Shihara1020/GP118-Line-Following-Robot/README.md

# Line Following Robot





An autonomous line-following robot powered by Arduino Uno, developed for the GP118 Line Following Competition, which secured 1st place against 60+ teams.

## Table of Contents
- [Competition Performance](#competition-performance)
- [Features](#features)
- [Project Task](#project-task)
- [Hardware Specifications](#hardware-specifications)
- [Media](#media)
- [Team](#team)
- [License](#license)

## Competition Performance
### Rounds Participated
| Round | Completion Time | Achievement |
|---|---|---|
| Preliminary | 16 seconds | Qualified for finals |
| Final | 21.9 seconds | **1st Place** |

### Key Achievement
- Beat the record time set by the 17th batch's robot
- Secured top position among 60+ competing teams

## Features
- Precise line following algorithm
- Automatic calibration system
- Robust performance across varying conditions
- Optimized speed control

## Project Task
The robot was designed to:
- Autonomously navigate complex line paths
- Handle sharp turns and intersections
- Maintain consistent speed and stability
- Adapt to different lighting and surface conditions

## Hardware Specifications
| Component | Description |
|---|---|
| Controller | Arduino Uno board |
| Motor Control | Motor shield |
| Sensors | IR sensor array |
| Actuators | 300 rpm gear motors |
| Power Management | Buck Converter, Boost Converter |
| Power Source | Battery pack |
| Mobility | Custom wheels |

## Media
### Robot Preview
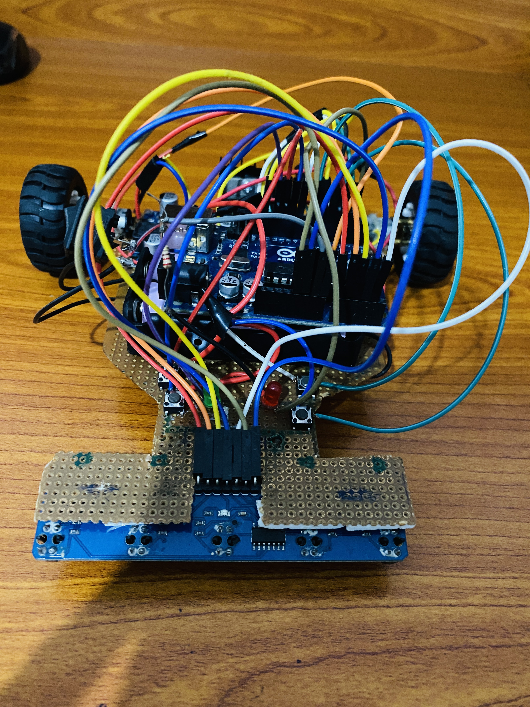
[picture p1: IMG_7238.jpg]
Robot Image


### Competition Track
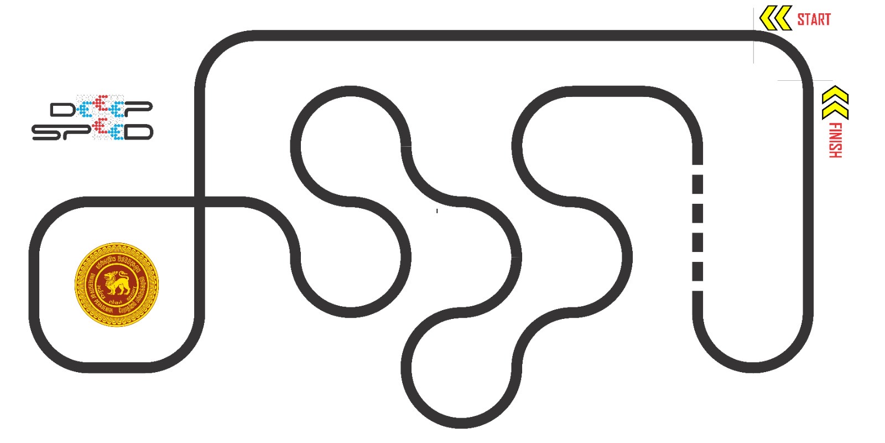
[picture p2: Our task.JPG]
Final Round Path


### Demonstration Video


## Team
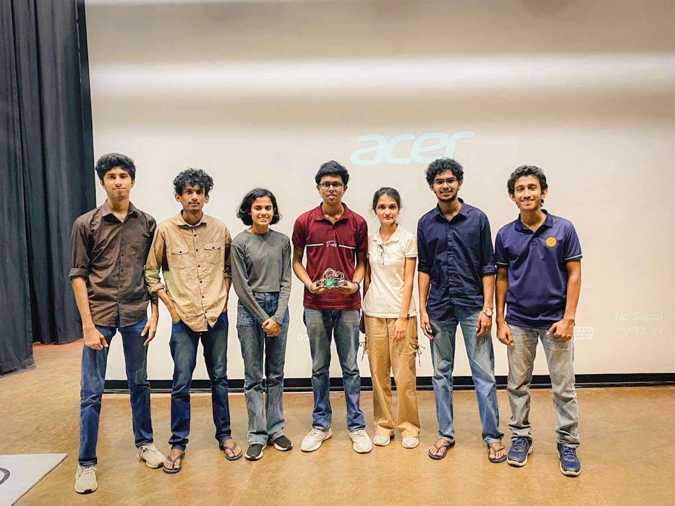
[picture p3: Our Team.JPG]
Team Photo


## License
This project is licensed under the MIT License - see the [LICENSE](LICENSE) file for details.
