Shihara1020/GP118-Line-Following-Robot/Solid works/Sample_chassie.png

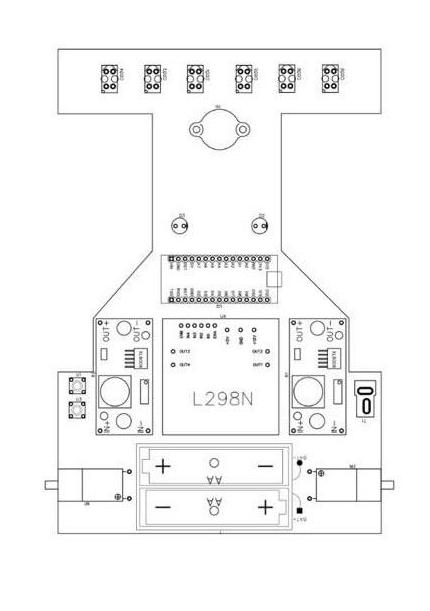
Solid works/Sample_chassie.png
