Shihara1020/GP118-Line-Following-Robot/(commit log)

2024-08-25 Create sample
2024-08-25 Sample chassie
